izaiah-thigpen/tt-sparse-conv/pcb/placement/placement-preview.png

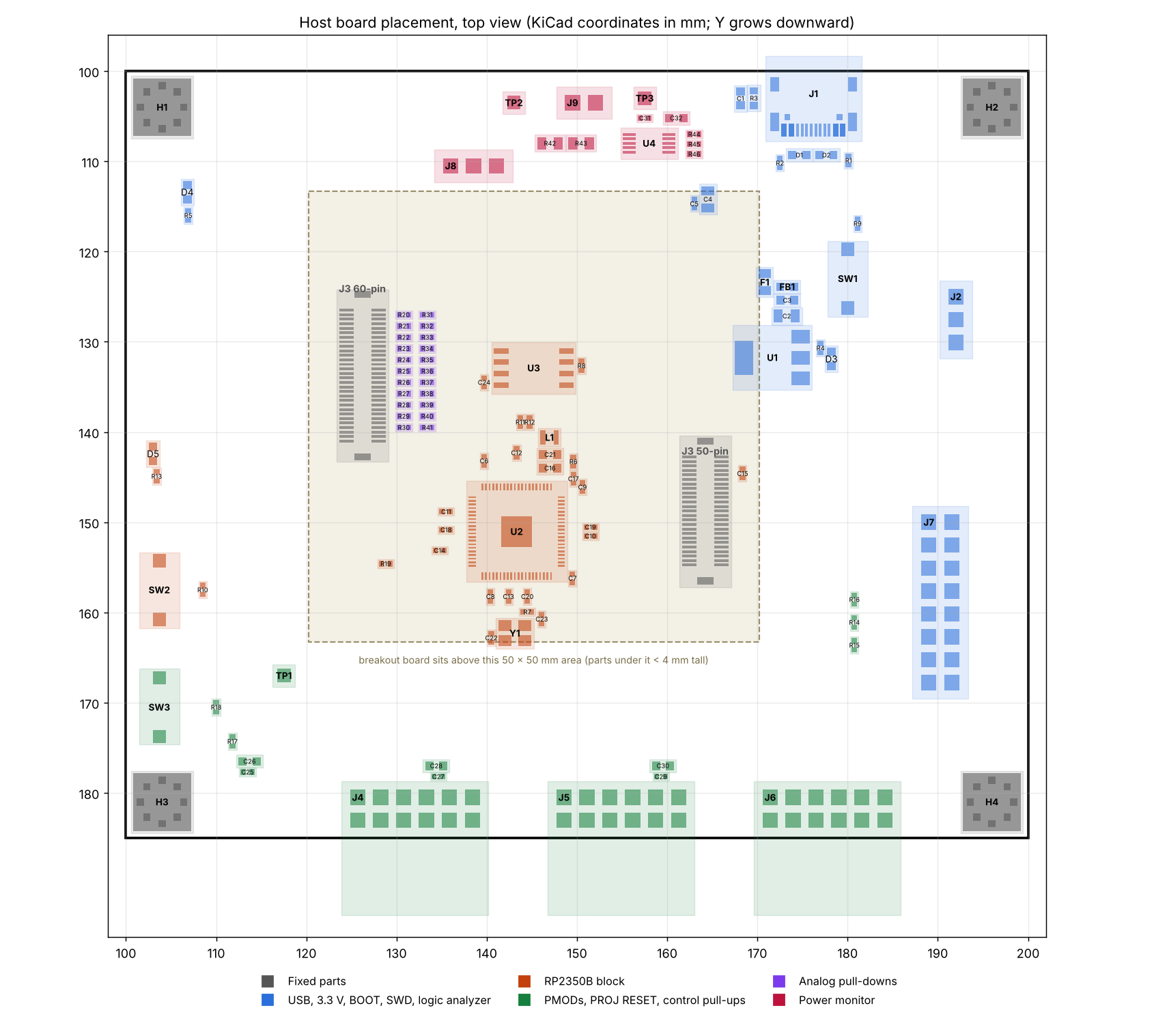
pcb/placement/placement-preview.png
