izaiah-thigpen/tt-sparse-conv/pcb/placement/placement.csv

group | ref | value | X (mm) | Y (mm) | Orientation (deg)
Fixed parts | H1 | M3 | 104.0 | 104.0 | 0
Fixed parts | H2 | M3 | 196.0 | 104.0 | 0
Fixed parts | H3 | M3 | 104.0 | 181.0 | 0
Fixed parts | H4 | M3 | 196.0 | 181.0 | 0
Fixed parts | J3 | TT breakout (DF12 60+50) | 126.225 | 133.8 | 0
USB, 3.3 V, BOOT, SWD, logic analyzer | C1 | 6800p | 168.11 | 103.025 | 90
USB, 3.3 V, BOOT, SWD, logic analyzer | C2 | 10u | 173.25 | 127.15 | 180
USB, 3.3 V, BOOT, SWD, logic analyzer | C3 | 1u | 173.3 | 125.4 | 180
USB, 3.3 V, BOOT, SWD, logic analyzer | C4 | 22u | 164.5 | 114.2 | 90
USB, 3.3 V, BOOT, SWD, logic analyzer | C5 | 100n | 163.0 | 114.7 | 90
USB, 3.3 V, BOOT, SWD, logic analyzer | D1 | ESD | 174.645 | 109.3 | 0
USB, 3.3 V, BOOT, SWD, logic analyzer | D2 | ESD | 177.645 | 109.3 | 180
USB, 3.3 V, BOOT, SWD, logic analyzer | D3 | Yellow | 178.2 | 131.9 | 90
USB, 3.3 V, BOOT, SWD, logic analyzer | D4 | Yellow | 106.8 | 113.41 | -90
USB, 3.3 V, BOOT, SWD, logic analyzer | F1 | 350mA | 170.8 | 123.4 | -90
USB, 3.3 V, BOOT, SWD, logic analyzer | FB1 | 120R | 173.3 | 123.9 | 0
USB, 3.3 V, BOOT, SWD, logic analyzer | J1 | USB_C | 176.21 | 102.5 | 180
USB, 3.3 V, BOOT, SWD, logic analyzer | J2 | SWD | 192.0 | 125.0 | 0
USB, 3.3 V, BOOT, SWD, logic analyzer | J7 | Logic analyzer | 189.0 | 150.0 | 0
USB, 3.3 V, BOOT, SWD, logic analyzer | R1 | 5.1k | 180.1 | 109.91 | -90
USB, 3.3 V, BOOT, SWD, logic analyzer | R2 | 5.1k | 172.5 | 110.19 | -90
USB, 3.3 V, BOOT, SWD, logic analyzer | R3 | 1M | 169.61 | 103.0 | 90
USB, 3.3 V, BOOT, SWD, logic analyzer | R4 | 1.2k | 177.0 | 130.7 | -90
USB, 3.3 V, BOOT, SWD, logic analyzer | R5 | 510 | 106.9 | 116.0 | 90
USB, 3.3 V, BOOT, SWD, logic analyzer | R9 | 1k | 181.1 | 116.9 | 90
USB, 3.3 V, BOOT, SWD, logic analyzer | SW1 | BOOT | 180.0 | 123.0 | 90
USB, 3.3 V, BOOT, SWD, logic analyzer | U1 | TLV1117LV33 | 171.65 | 131.75 | 180
RP2350B block | C6 | 100n | 139.7 | 143.2 | 90
RP2350B block | C7 | 100n | 149.5 | 156.2 | -90
RP2350B block | C8 | 100n | 140.4 | 158.235 | -90
RP2350B block | C9 | 100n | 150.6 | 146.1 | 90
RP2350B block | C10 | 100n | 151.488 | 151.535 | 0
RP2350B block | C11 | 100n | 135.488 | 148.835 | 180
RP2350B block | C12 | 100n | 143.3 | 142.3 | 90
RP2350B block | C13 | 100n | 142.4 | 158.235 | -90
RP2350B block | C14 | 100n | 134.771 | 153.127 | 180
RP2350B block | C15 | 100n | 168.35 | 144.6 | 90
RP2350B block | C16 | 4.7u | 147.0 | 144.0 | 0
RP2350B block | C17 | 4.7u | 149.6 | 145.18 | -90
RP2350B block | C18 | 100n | 135.488 | 150.835 | 180
RP2350B block | C19 | 100n | 151.488 | 150.535 | 0
RP2350B block | C20 | 4.7u | 144.488 | 158.235 | -90
RP2350B block | C21 | 4.7u | 147.0 | 142.5 | 0
RP2350B block | C22 | 14p | 140.5 | 162.82 | 90
RP2350B block | C23 | 14p | 146.088 | 160.735 | -90
RP2350B block | C24 | 100n | 139.7 | 134.5 | 90
RP2350B block | D5 | Yellow | 103.0 | 142.41 | -90
RP2350B block | L1 | 3.3u | 146.95 | 140.6 | 0
RP2350B block | R6 | 33 | 149.6 | 143.28 | -90
RP2350B block | R7 | 1k | 144.488 | 159.935 | 0
RP2350B block | R8 | 10k | 150.5 | 132.665 | -90
RP2350B block | R10 | 10k | 108.5 | 157.5 | 90
RP2350B block | R11 | 27 | 143.7 | 138.9 | -90
RP2350B block | R12 | 27 | 144.75 | 138.9 | -90
RP2350B block | R13 | 510 | 103.4 | 144.91 | 90
RP2350B block | R19 | 33 | 128.8 | 154.6 | 180
RP2350B block | SW2 | RESET | 103.7 | 157.5 | 90
RP2350B block | U2 | RP2350B | 143.317 | 151.035 | 0
RP2350B block | U3 | W25Q32JVSS | 145.2 | 132.9 | 180
RP2350B block | Y1 | 12MHz | 143.1 | 162.3 | 0
PMODs, PROJ RESET, control pull-ups | C25 | 100n | 113.475 | 177.69 | 0
PMODs, PROJ RESET, control pull-ups | C26 | 1u | 113.7 | 176.5 | 180
PMODs, PROJ RESET, control pull-ups | C27 | 100n | 134.62 | 178.2 | 180
PMODs, PROJ RESET, control pull-ups | C28 | 1u | 134.395 | 177.0 | 0
PMODs, PROJ RESET, control pull-ups | C29 | 100n | 159.3 | 178.2 | 0
PMODs, PROJ RESET, control pull-ups | C30 | 1u | 159.525 | 176.99 | 180
PMODs, PROJ RESET, control pull-ups | J4 | PMOD in (ui_in) | 125.7 | 180.5 | 90
PMODs, PROJ RESET, control pull-ups | J5 | PMOD bidir (uio) | 148.56 | 180.5 | 90
PMODs, PROJ RESET, control pull-ups | J6 | PMOD out (uo_out) | 171.42 | 180.5 | 90
PMODs, PROJ RESET, control pull-ups | R14 | 10k | 180.75 | 161.1 | -90
PMODs, PROJ RESET, control pull-ups | R15 | 5.1k | 180.75 | 163.63 | -90
PMODs, PROJ RESET, control pull-ups | R16 | 10k | 180.75 | 158.57 | 90
PMODs, PROJ RESET, control pull-ups | R17 | 1k | 111.8 | 174.3 | 90
PMODs, PROJ RESET, control pull-ups | R18 | 10k | 110.0 | 170.5 | 90
PMODs, PROJ RESET, control pull-ups | SW3 | PROJ RESET | 103.7 | 170.5 | -90
PMODs, PROJ RESET, control pull-ups | TP1 | PROJ_CLK | 117.5 | 167.0 | 0
Analog pull-downs | R20 | 10M | 130.8 | 127.0 | 0
Analog pull-downs | R21 | 10M | 130.8 | 128.25 | 0
Analog pull-downs | R22 | 10M | 130.8 | 129.5 | 0
Analog pull-downs | R23 | 10M | 130.8 | 130.75 | 0
Analog pull-downs | R24 | 10M | 130.8 | 132.0 | 0
Analog pull-downs | R25 | 10M | 130.8 | 133.25 | 0
Analog pull-downs | R26 | 10M | 130.8 | 134.5 | 0
Analog pull-downs | R27 | 10M | 130.8 | 135.75 | 0
Analog pull-downs | R28 | 10M | 130.8 | 137.0 | 0
Analog pull-downs | R29 | 10M | 130.8 | 138.25 | 0
Analog pull-downs | R30 | 10M | 130.8 | 139.5 | 0
Analog pull-downs | R31 | 10M | 133.4 | 127.0 | 0
Analog pull-downs | R32 | 10M | 133.4 | 128.25 | 0
Analog pull-downs | R33 | 10M | 133.4 | 129.5 | 0
Analog pull-downs | R34 | 10M | 133.4 | 130.75 | 0
Analog pull-downs | R35 | 10M | 133.4 | 132.0 | 0
Analog pull-downs | R36 | 10M | 133.4 | 133.25 | 0
Analog pull-downs | R37 | 10M | 133.4 | 134.5 | 0
Analog pull-downs | R38 | 10M | 133.4 | 135.75 | 0
Analog pull-downs | R39 | 10M | 133.4 | 137.0 | 0
Analog pull-downs | R40 | 10M | 133.4 | 138.25 | 0
Analog pull-downs | R41 | 10M | 133.4 | 139.5 | 0
Power monitor | C31 | 100n | 157.5 | 105.2 | 0
Power monitor | C32 | 1u | 161.0 | 105.2 | 0
Power monitor | J8 | CORE | 136.0 | 110.5 | 90
Power monitor | J9 | RANGE | 149.5 | 103.5 | 90
Power monitor | R42 | 0.499 | 147.0 | 108.0 | 0
Power monitor | R43 | 4.99 | 150.45 | 108.0 | 0
Power monitor | R44 | 4.7k | 163.0 | 107.0 | 0
Power monitor | R45 | 4.7k | 163.0 | 108.1 | 0
Power monitor | R46 | 10k | 163.0 | 109.2 | 0
Power monitor | TP2 | VCORE_IN | 143.0 | 103.5 | 0
Power monitor | TP3 | VCORE_OUT | 157.5 | 103.0 | 0
Power monitor | U4 | INA228 | 158.0 | 108.0 | 180
