izaiah-thigpen/tt-sparse-conv/power/results/power.md

| Zero share | Chip gated (µW) | Chip BYPASS (µW) | Chip saving | Saving above idle | MAC gated (µW) | MAC BYPASS (µW) | MAC saving | MAC dynamic saving |
| --- | --- | --- | --- | --- | --- | --- | --- | --- |
| 0% | 1070.8 | 1070.8 | 0.0% | 0.0% | 353.4 | 353.4 | 0.0% | 0.0% |
| 25% | 1029.6 | 1051.5 | 2.1% | 6.4% | 311.6 | 333.4 | 6.5% | 10.2% |
| 50% | 973.2 | 1015.4 | 4.2% | 13.8% | 258.1 | 300.3 | 14.0% | 23.3% |
| 75% | 910.9 | 971.1 | 6.2% | 23.0% | 200.1 | 260.3 | 23.1% | 42.8% |
| 90% | 864.5 | 936.2 | 7.7% | 31.6% | 156.1 | 227.9 | 31.5% | 66.3% |

Idle (clock running, no computation): chip 709.1 µW, MAC 119.6 µW
