izaiah-thigpen/tt-sparse-conv/power/results/power.csv

condition | zero_share | total_uW | sequential_uW | combinational_uW | leakage_uW | mac_uW
idle |  | 709.12 | 709.12 | 0.00 | 0.0083 | 119.61
T0_gated | 0.0 | 1070.82 | 810.05 | 260.78 | 0.0082 | 353.42
T0_bypass | 0.0 | 1070.82 | 810.05 | 260.78 | 0.0082 | 353.42
T64_gated | 0.25 | 1029.65 | 800.90 | 228.74 | 0.0082 | 311.57
T64_bypass | 0.25 | 1051.46 | 808.23 | 243.23 | 0.0082 | 333.38
T128_gated | 0.5 | 973.21 | 789.59 | 183.63 | 0.0082 | 258.14
T128_bypass | 0.5 | 1015.37 | 801.94 | 213.43 | 0.0082 | 300.29
T192_gated | 0.75 | 910.90 | 777.93 | 132.97 | 0.0083 | 200.13
T192_bypass | 0.75 | 971.12 | 792.58 | 178.54 | 0.0082 | 260.35
T230_gated | 0.8984375 | 864.45 | 769.11 | 95.34 | 0.0083 | 156.14
T230_bypass | 0.8984375 | 936.24 | 784.53 | 151.70 | 0.0081 | 227.92
