izaiah-thigpen/tt-sparse-conv/pcb/sparse-conv-host-schematic.pdf

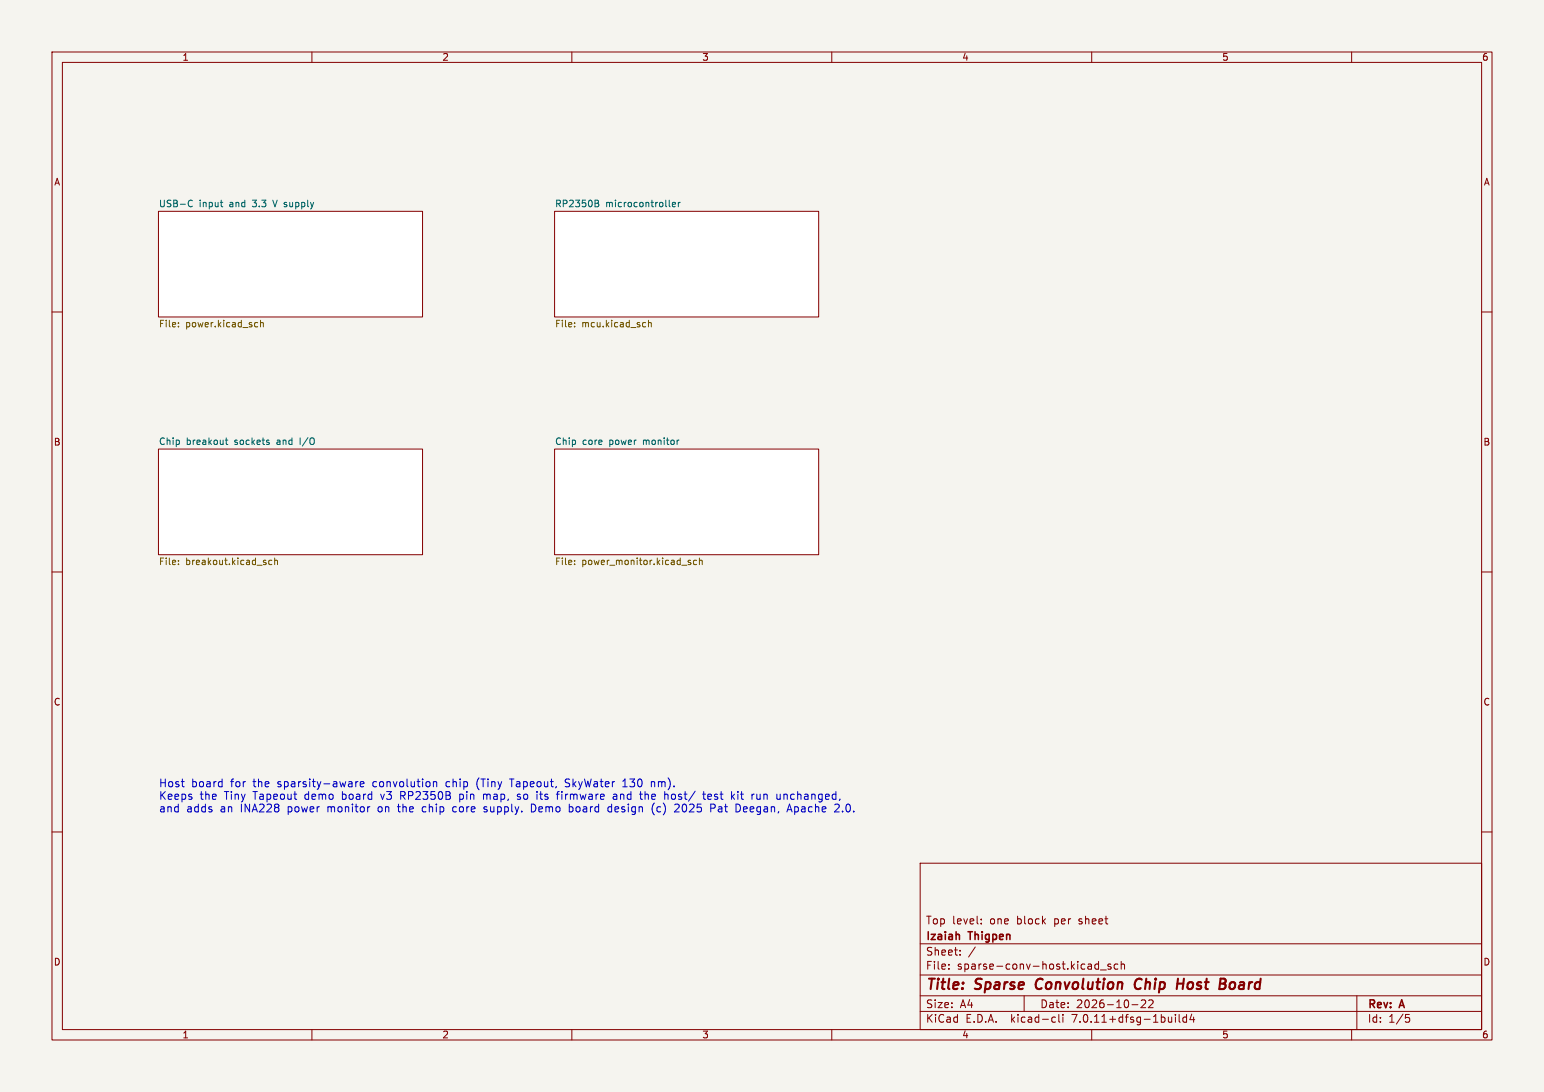
[picture p6: page 1]

File: sparse-conv-host.kicad_sch Sheet: /
Id: 1/5 Title: Sparse Convolution Chip Host Board

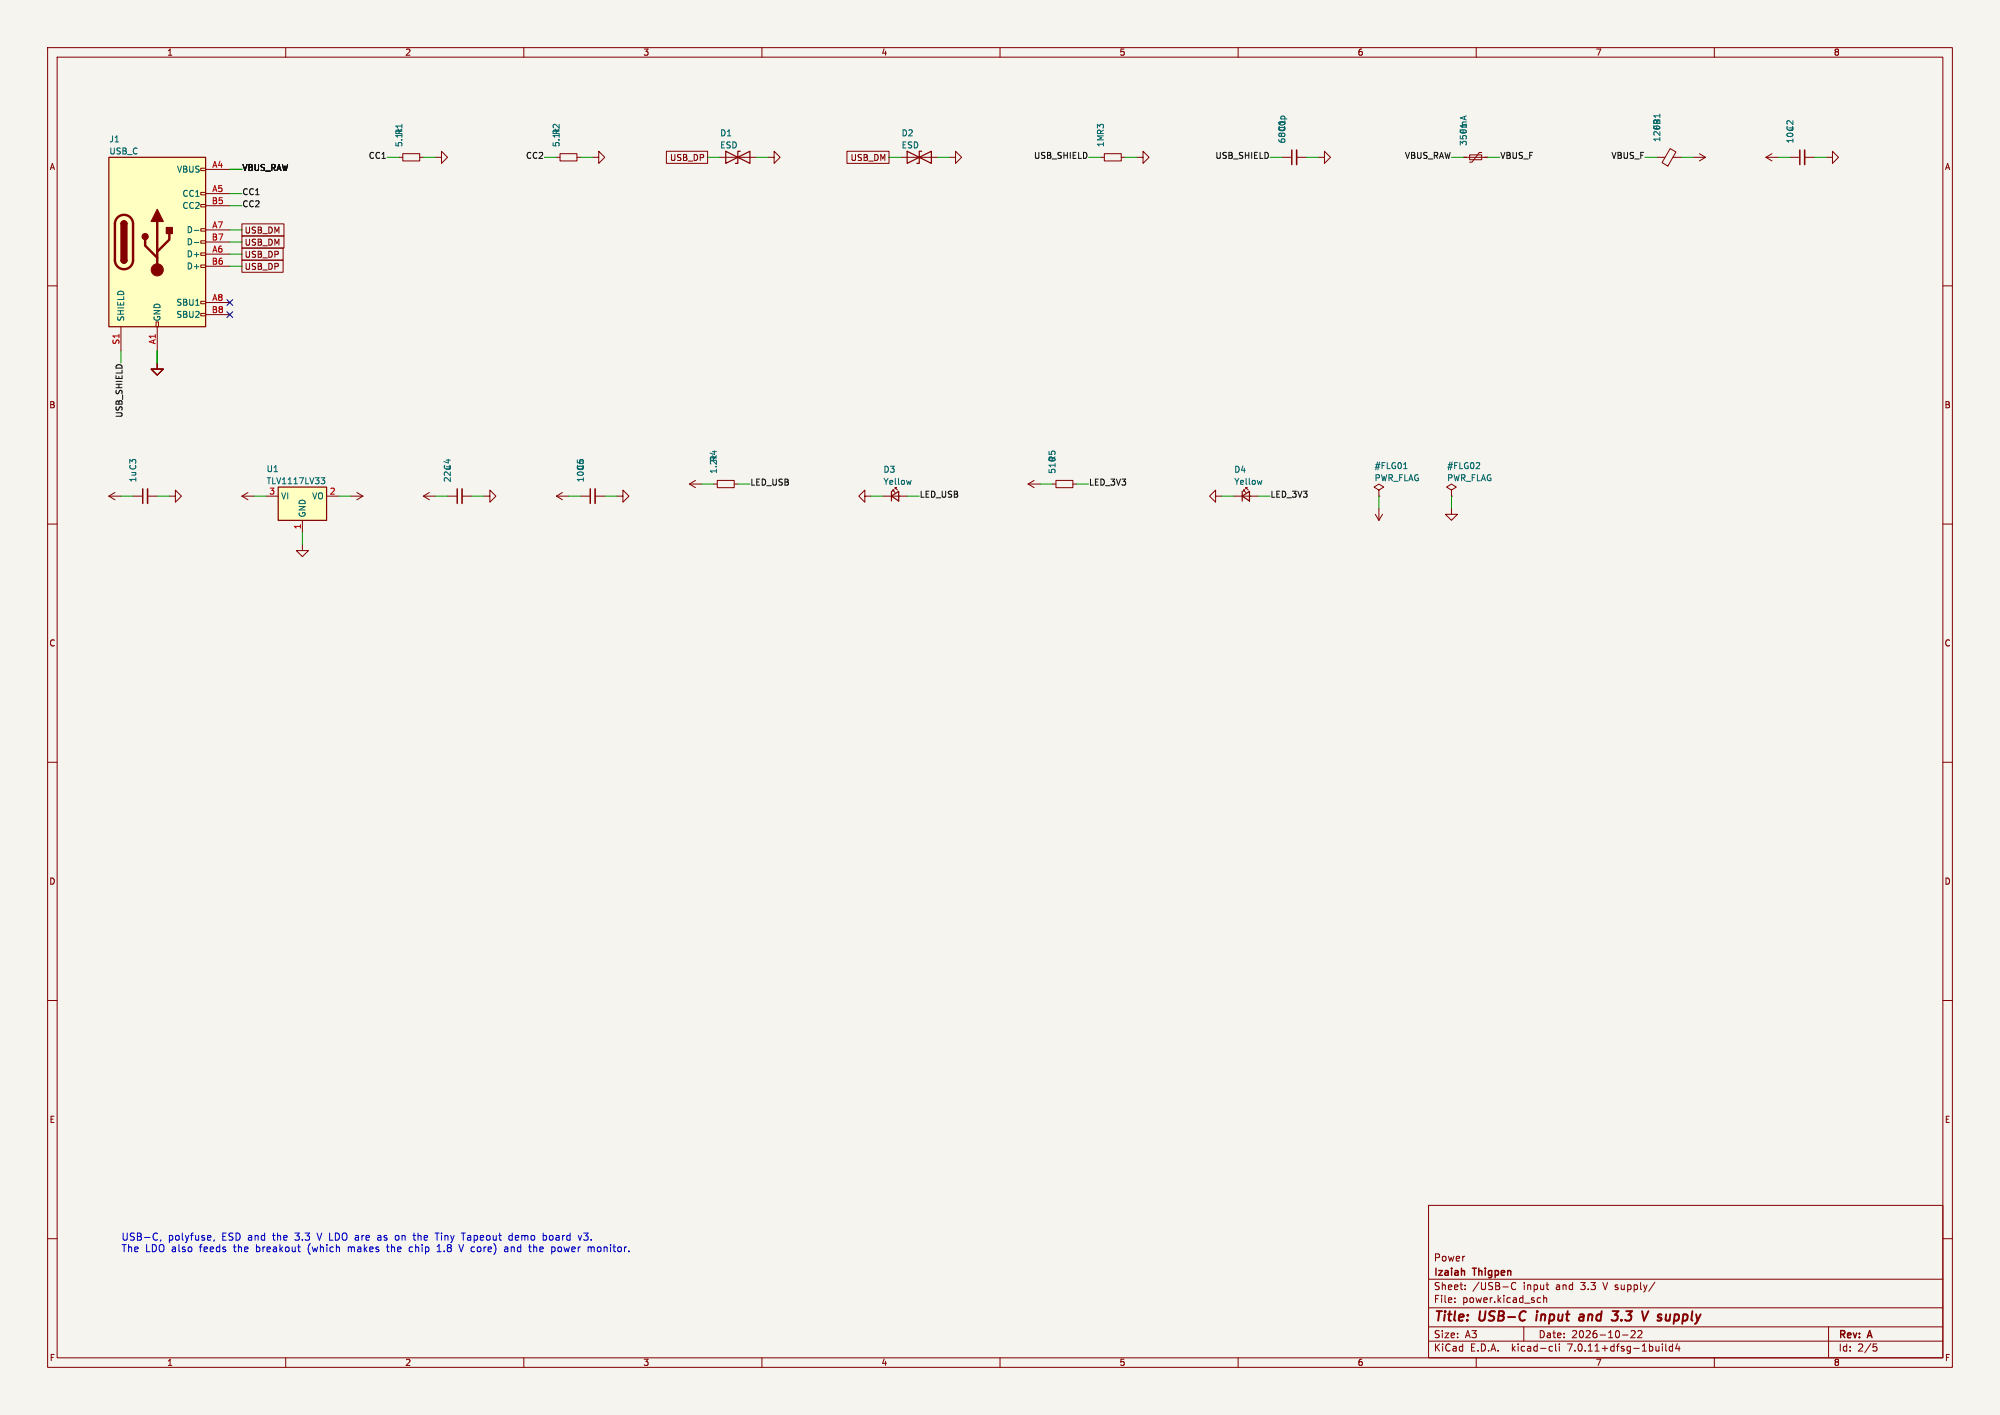
[picture p7: page 2]

Id: 2/5 Title: USB-C input and 3.3 V supply

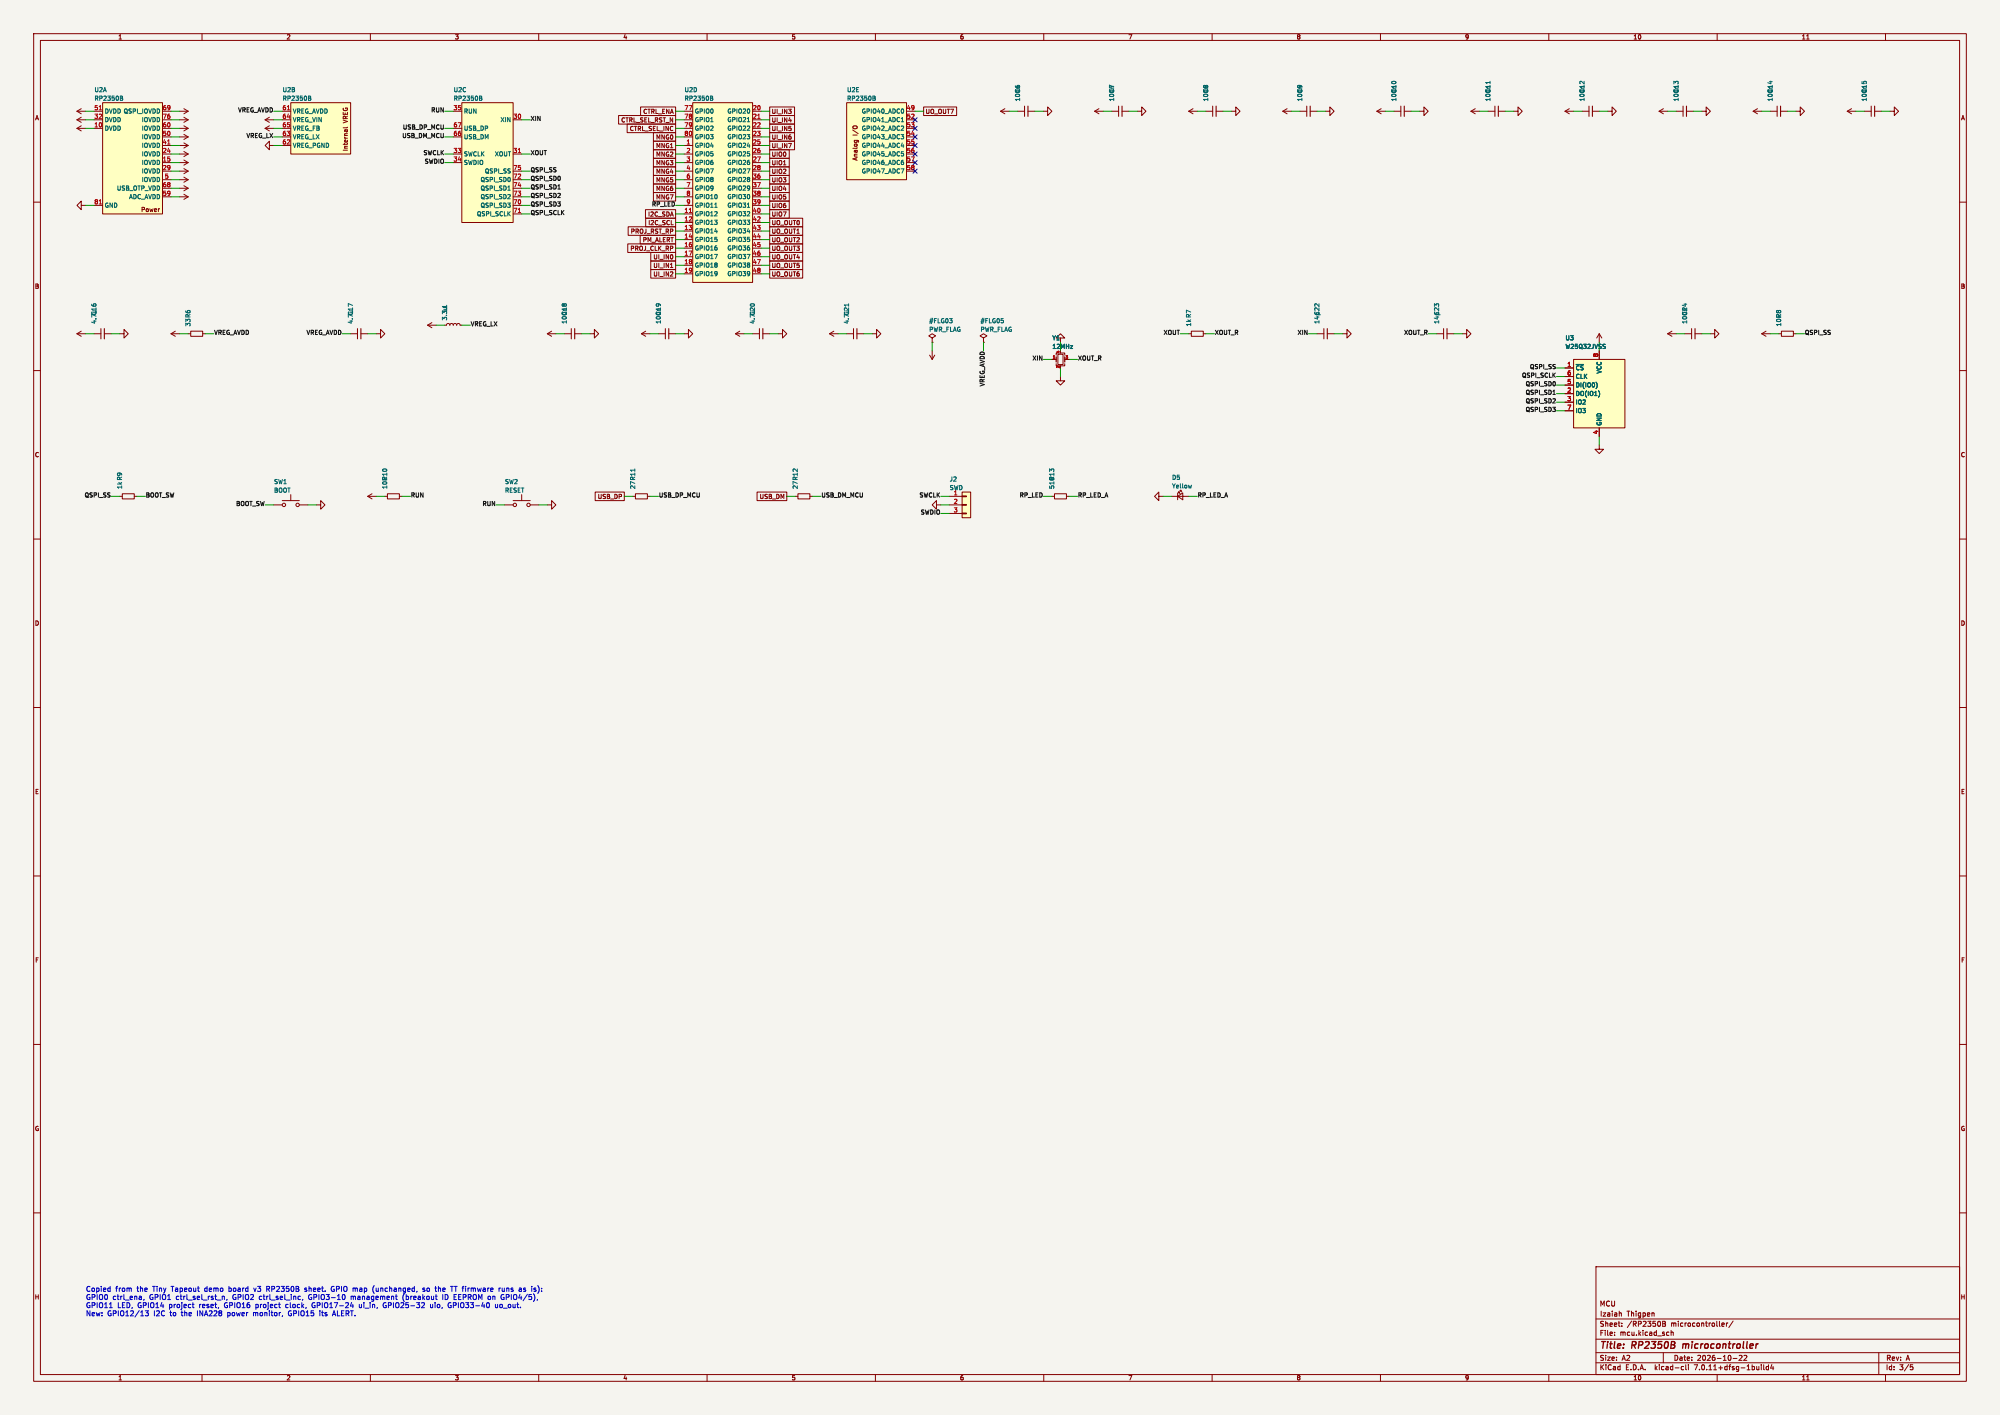
[picture p8: page 3]

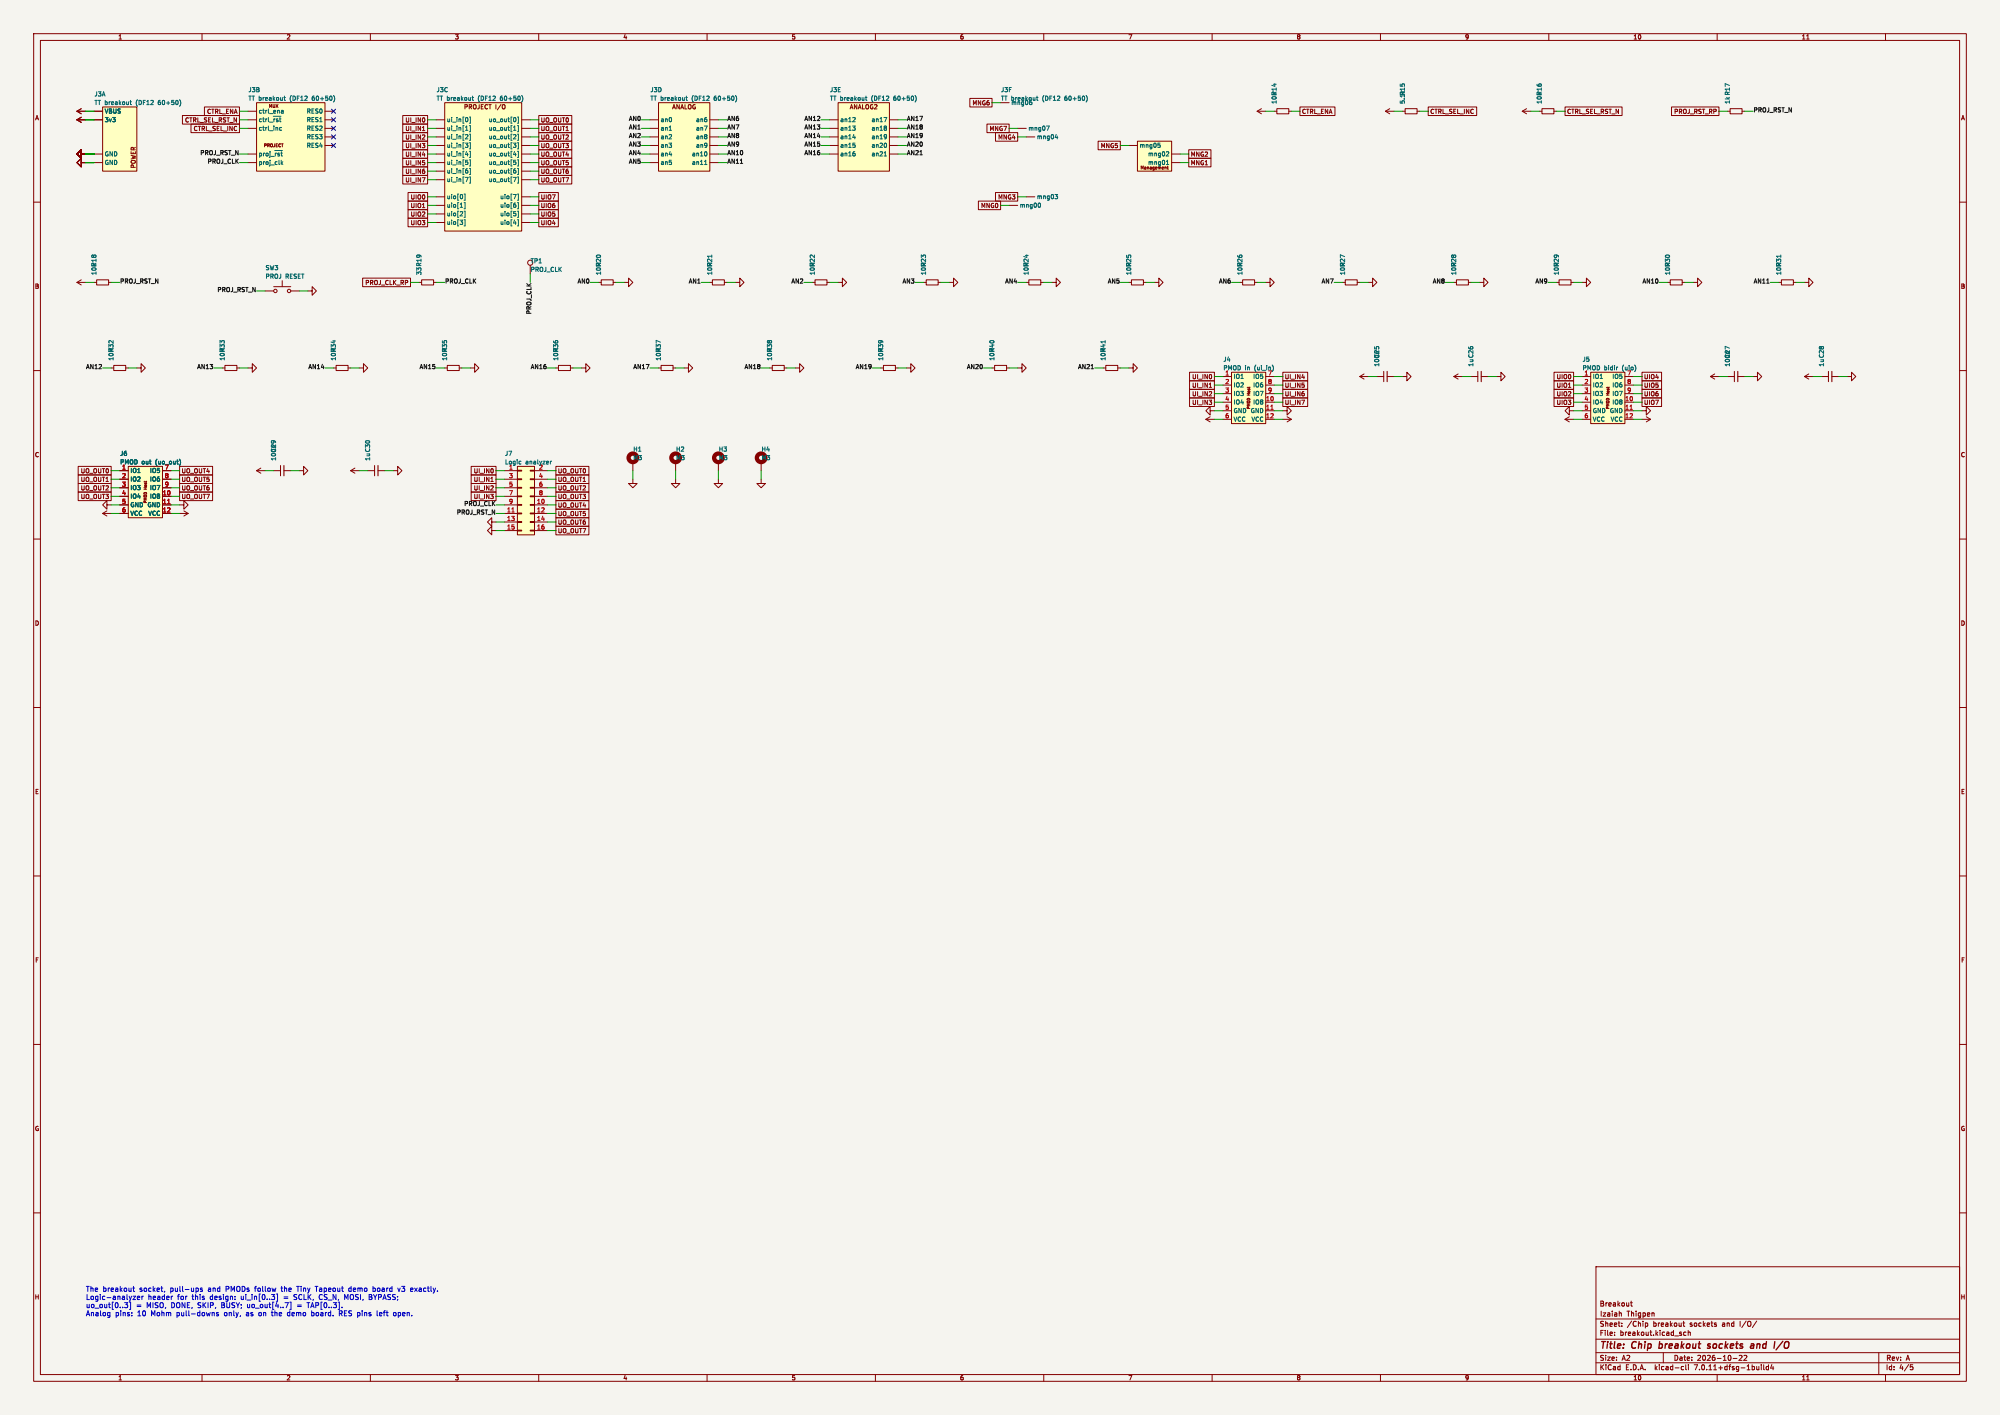
[picture p9: page 4]

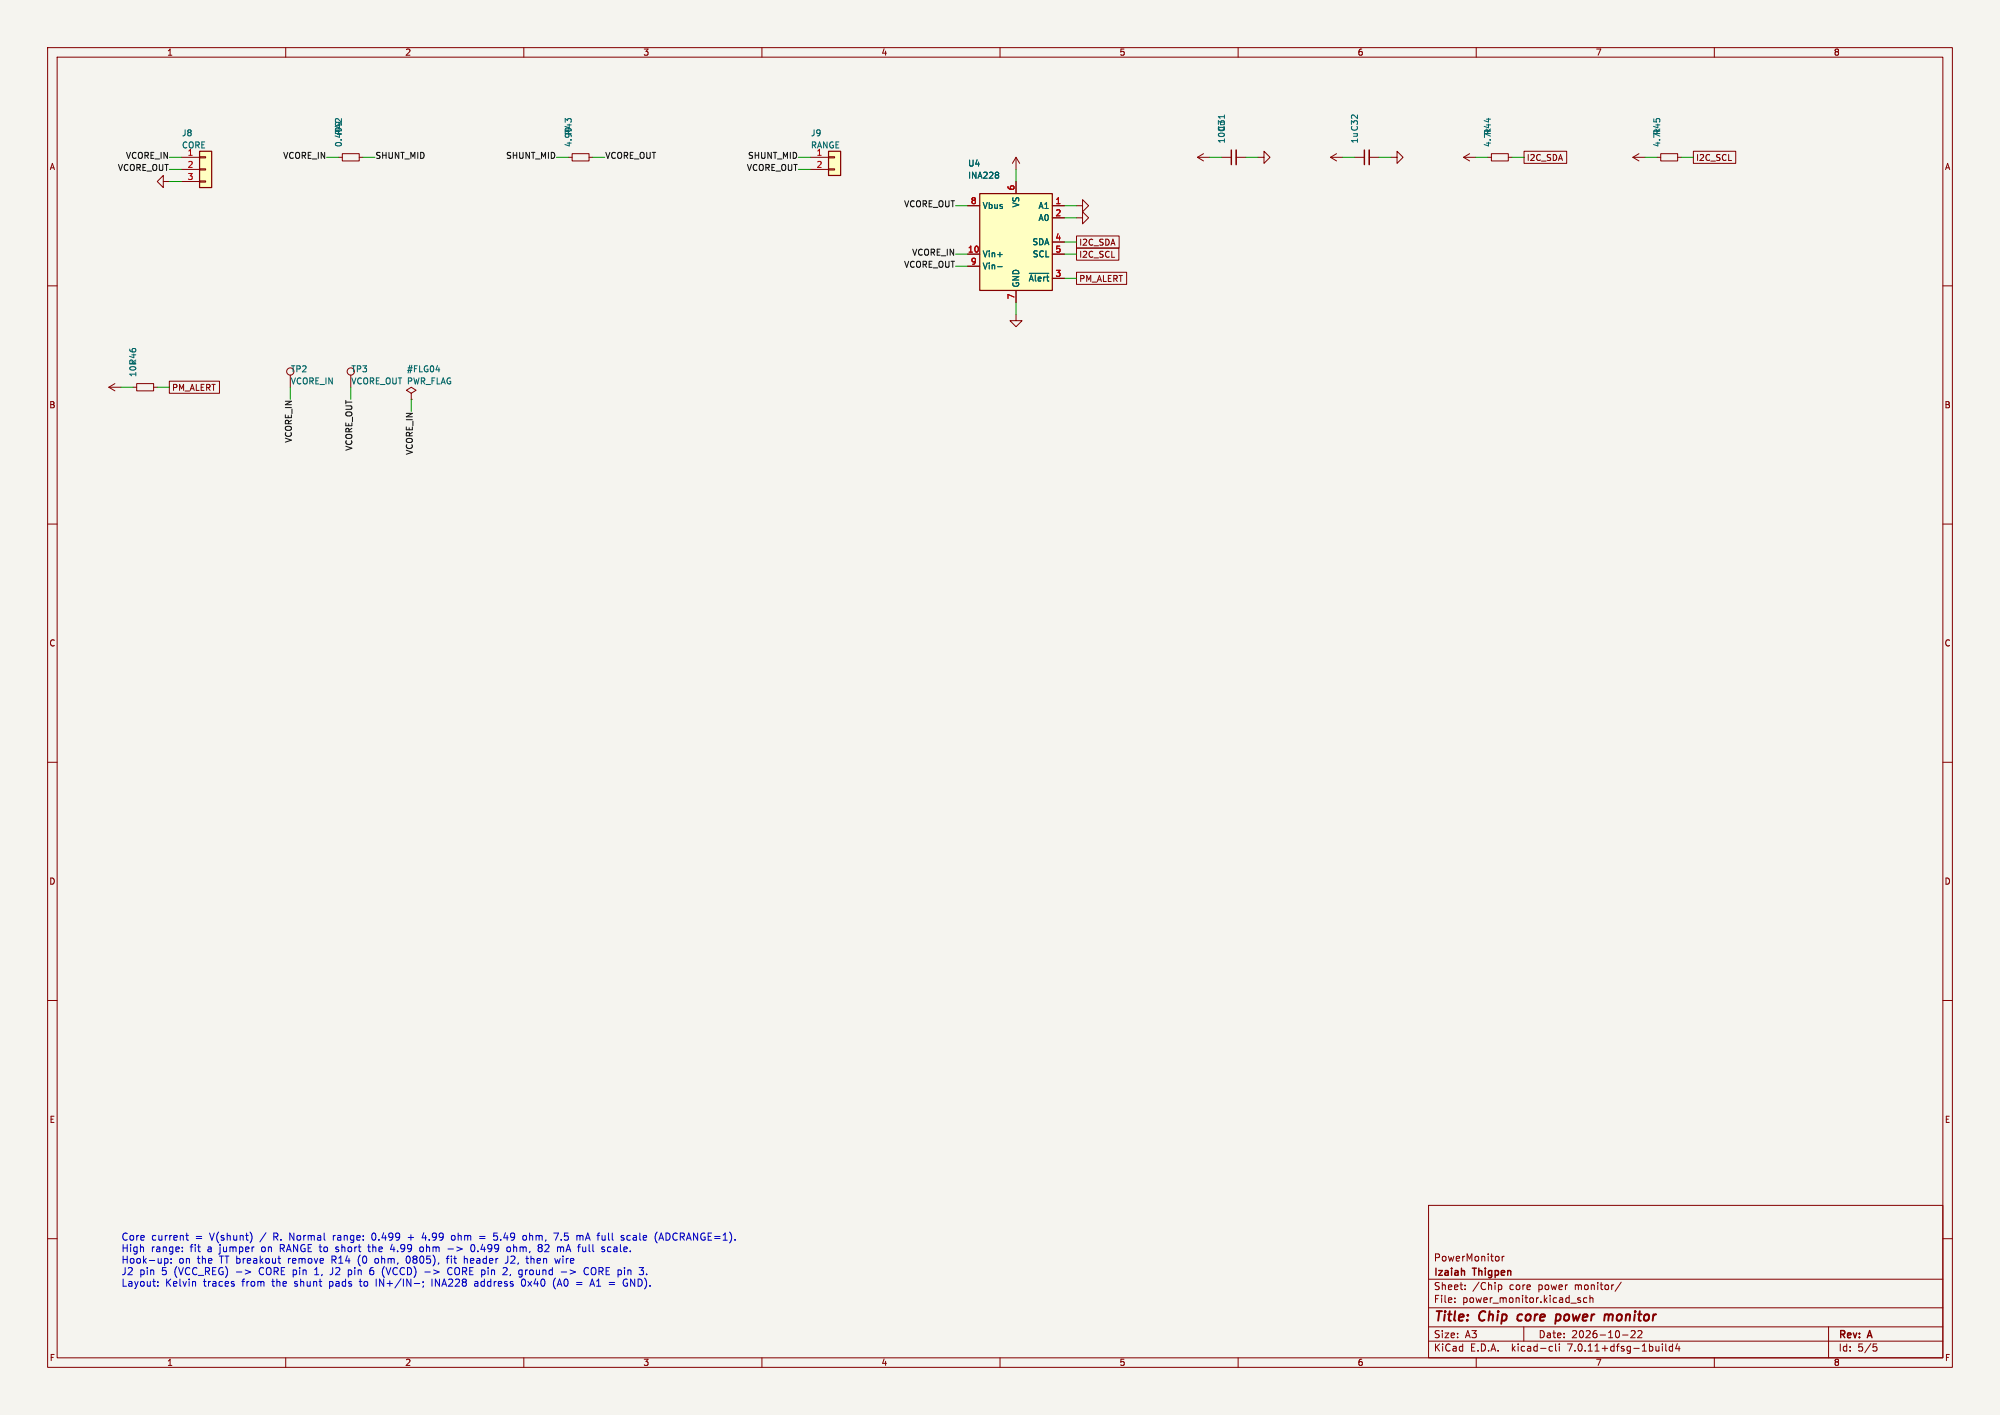
[picture p10: page 5]
