izaiah-thigpen/tt-sparse-conv/pcb/placement/sparse-conv-host-placed.kicad_pcb

## KiCad design pcb/placement/sparse-conv-host-placed.kicad_pcb (2026-10-24)

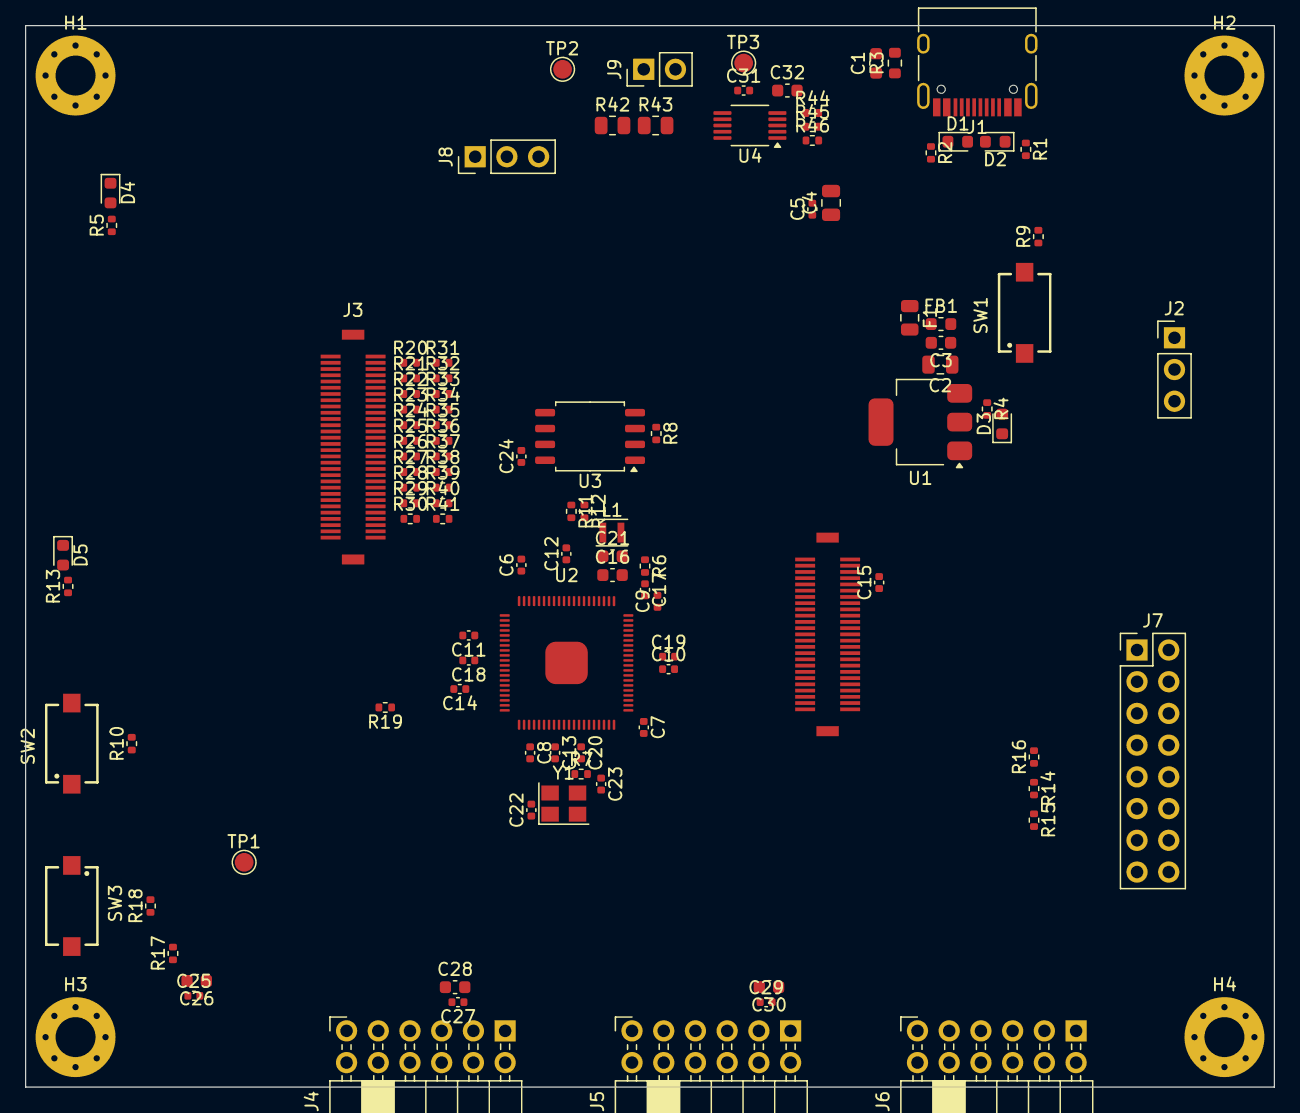
[picture p11: board sparse-conv-host-placed.kicad_pcb from above]

Board: 4 copper layers, 100.0 x 85.0 mm, 110 parts (0 on the bottom side), 99 nets, no tracks yet.

Parts:
C1, C3, C16, C21, C26, C28, C30, C32: C_0603_1608Metric
C2, C4: C_0805_2012Metric
C5, C6, C7, C8, C9, C10, C11, C12, C13, C14, C15, C17, C18, C19, C20, C22, C23, C24, C25, C27, C29, C31: C_0402_1005Metric
D1, D2: D_0603_1608Metric
D3, D4, D5: LED_0603_1608Metric
F1: Fuse_0805_2012Metric
FB1: L_0603_1608Metric
H1, H2, H3, H4: MountingHole_3.2mm_M3_Pad_Via
J1: USB_C_Receptacle_HRO_TYPE-C-31-M-12
J2, J8: PinHeader_1x03_P2.54mm_Vertical
J3: TT; TT_HRS_CARRIER_REVC
J4, J5, J6: PinSocket_2x06_P2.54mm_PMODHost1A
J7: PinHeader_2x08_P2.54mm_Vertical
J9: PinHeader_1x02_P2.54mm_Vertical
L1: L_Murata_DFE201610P
R1, R2, R4, R5, R6, R7, R8, R9, R10, R11, R12, R13, R14, R15, R16, R17, R18, R19, R20, R21, R22, R23, R24, R25, R26, R27, R28, R29, R30, R31, R32, R33, R34, R35, R36, R37, R38, R39, R40, R41, R44, R45, R46: R_0402_1005Metric
R3: R_0603_1608Metric
R42, R43: R_0805_2012Metric
SW1, SW2, SW3: 434121025816
TP1, TP2, TP3: TestPoint_Pad_D1.5mm
U1: SOT-223-3_TabPin2
U2: QFN; QFN-80-1EP_10x10mm_P0.4mm_EP3.4x3.4mm
U3: SOIC-8_5.275x5.275mm_P1.27mm
U4: VSSOP-10_3x3mm_P0.5mm
Y1: Crystal_SMD_3225-4Pin_3.2x2.5mm

Connections:
+1V1: C18.1, C19.1, C20.1, C21.1, L1.1, U2.10, U2.32, U2.51, U2.65
+3V3: C4.1, C5.1, C6.1, C7.1, C8.1, C9.1, C10.1, C11.1, C12.1, C13.1, C14.1, C15.1, C16.1, C24.1, C25.1, C26.1, C27.1, C28.1, C29.1, C30.1, C31.1, C32.1, J3.L1, J3.R8, J3.R10, J4.6, J4.12, J5.6, J5.12, J6.6, J6.12, R5.1, R6.1, R8.1, R10.1, R14.1, R15.1, R16.1, R18.1, R44.1, R45.1, R46.1, U1.2, U2.5, U2.15, U2.24, U2.29, U2.41, U2.50, U2.59, U2.60, U2.64, U2.68, U2.69, U2.76, U3.8, U4.6
+5V: C2.1, C3.1, FB1.2, J3.R2, J3.R4, R4.1, U1.3
/Chip breakout sockets and I/O/AN0: J3.L2, R20.1
/Chip breakout sockets and I/O/AN1: J3.L4, R21.1
/Chip breakout sockets and I/O/AN2: J3.L6, R22.1
/Chip breakout sockets and I/O/AN3: J3.L10, R23.1
/Chip breakout sockets and I/O/AN4: J3.L12, R24.1
/Chip breakout sockets and I/O/AN5: J3.L14, R25.1
/Chip breakout sockets and I/O/AN6: J3.L18, R26.1
/Chip breakout sockets and I/O/AN7: J3.L20, R27.1
/Chip breakout sockets and I/O/AN8: J3.L22, R28.1
/Chip breakout sockets and I/O/AN9: J3.L26, R29.1
/Chip breakout sockets and I/O/AN10: J3.L28, R30.1
/Chip breakout sockets and I/O/AN11: J3.L30, R31.1
/Chip breakout sockets and I/O/AN12: J3.L34, R32.1
/Chip breakout sockets and I/O/AN13: J3.L36, R33.1
/Chip breakout sockets and I/O/AN14: J3.L38, R34.1
/Chip breakout sockets and I/O/AN15: J3.L42, R35.1
/Chip breakout sockets and I/O/AN16: J3.L44, R36.1
/Chip breakout sockets and I/O/AN17: J3.L46, R37.1
/Chip breakout sockets and I/O/AN18: J3.L50, R38.1
/Chip breakout sockets and I/O/AN19: J3.L52, R39.1
/Chip breakout sockets and I/O/AN20: J3.L54, R40.1
/Chip breakout sockets and I/O/AN21: J3.L58, R41.1
/Chip breakout sockets and I/O/PROJ_CLK: J3.L57, J7.9, R19.2, TP1.1
/Chip breakout sockets and I/O/PROJ_RST_N: J3.L53, J7.11, R17.2, R18.2, SW3.1
/Chip core power monitor/SHUNT_MID: J9.1, R42.2, R43.1
/Chip core power monitor/VCORE_IN: J8.1, R42.1, TP2.1, U4.10
/Chip core power monitor/VCORE_OUT: J8.2, J9.2, R43.2, TP3.1, U4.8, U4.9
/RP2350B microcontroller/BOOT_SW: R9.2, SW1.1
/RP2350B microcontroller/QSPI_SCLK: U2.71, U3.6
/RP2350B microcontroller/QSPI_SD0: U2.72, U3.5
/RP2350B microcontroller/QSPI_SD1: U2.74, U3.2
/RP2350B microcontroller/QSPI_SD2: U2.73, U3.3
/RP2350B microcontroller/QSPI_SD3: U2.70, U3.7
/RP2350B microcontroller/QSPI_SS: R8.2, R9.1, U2.75, U3.1
/RP2350B microcontroller/RP_LED: R13.1, U2.9
/RP2350B microcontroller/RP_LED_A: D5.2, R13.2
/RP2350B microcontroller/RUN: R10.2, SW2.1, U2.35
/RP2350B microcontroller/SWCLK: J2.1, U2.33
/RP2350B microcontroller/SWDIO: J2.3, U2.34
/RP2350B microcontroller/USB_DM_MCU: R12.2, U2.66
/RP2350B microcontroller/USB_DP_MCU: R11.2, U2.67
/RP2350B microcontroller/VREG_AVDD: C17.1, R6.2, U2.61
/RP2350B microcontroller/VREG_LX: L1.2, U2.63
/RP2350B microcontroller/XIN: C22.1, U2.30, Y1.1
/RP2350B microcontroller/XOUT: R7.1, U2.31
/RP2350B microcontroller/XOUT_R: C23.1, R7.2, Y1.3
/USB-C input and 3.3 V supply/CC1: J1.A5, R1.1
/USB-C input and 3.3 V supply/CC2: J1.B5, R2.1
/USB-C input and 3.3 V supply/LED_3V3: D4.2, R5.2
/USB-C input and 3.3 V supply/LED_USB: D3.2, R4.2
/USB-C input and 3.3 V supply/USB_SHIELD: C1.1, J1.S1, R3.1
/USB-C input and 3.3 V supply/VBUS_F: F1.2, FB1.1
/USB-C input and 3.3 V supply/VBUS_RAW: F1.1, J1.A4, J1.A9, J1.B4, J1.B9
CTRL_ENA: J3.R46, R14.2, U2.77
CTRL_SEL_INC: J3.R47, R15.2, U2.79
CTRL_SEL_RST_N: J3.R43, R16.2, U2.78
GND: C1.2, C2.2, C3.2, C4.2, C5.2, C6.2, C7.2, C8.2, C9.2, C10.2, C11.2, C12.2, C13.2, C14.2, C15.2, C16.2, C17.2, C18.2, C19.2, C20.2, C21.2, C22.2, C23.2, C24.2, C25.2, C26.2, C27.2, C28.2, C29.2, C30.2, C31.2, C32.2, D1.2, D2.2, D3.1, D4.1, D5.1, H1.1, H2.1, H3.1, H4.1, J1.A1, J1.A12, J1.B1, J1.B12, J2.2, J3.L3, J3.L8, J3.L11, J3.L16, J3.L19, J3.L24, J3.L27, J3.L32, J3.L35, J3.L40, J3.L43, J3.L48, J3.L51, J3.L55, J3.L56, J3.L59, J3.R1, J3.R6, J3.R11, J3.R12, J3.R20, J3.R21, J3.R28, J3.R33, J3.R38, J3.R41, J3.R44, J3.R45, J3.R48, J4.5, J4.11, J5.5, J5.11, J6.5, J6.11, J7.13, J7.15, J8.3, R1.2, R2.2, R3.2, R20.2, R21.2, R22.2, R23.2, R24.2, R25.2, R26.2, R27.2, R28.2, R29.2, R30.2, R31.2, R32.2, R33.2, R34.2, R35.2, R36.2, R37.2, R38.2, R39.2, R40.2, R41.2, SW1.2, SW2.2, SW3.2, U1.1, U2.62, U2.81, U3.4, U4.1, U4.2, U4.7, Y1.2, Y1.4
I2C_SCL: R45.2, U2.12, U4.5
I2C_SDA: R44.2, U2.11, U4.4
MNG0: J3.R42, U2.80
MNG1: J3.R40, U2.1
MNG2: J3.R36, U2.2
MNG3: J3.R30, U2.3
MNG4: J3.R26, U2.4
MNG5: J3.R22, U2.6
MNG6: J3.R18, U2.7
MNG7: J3.R16, U2.8
PM_ALERT: R46.2, U2.14, U4.3
PROJ_CLK_RP: R19.1, U2.16
PROJ_RST_RP: R17.1, U2.13
UIO0: J3.L5, J5.1, U2.26
UIO1: J3.L7, J5.2, U2.27
UIO2: J3.L9, J5.3, U2.28
UIO3: J3.L13, J5.4, U2.36
UIO4: J3.L15, J5.7, U2.37
UIO5: J3.L17, J5.8, U2.38
UIO6: J3.L21, J5.9, U2.39
UIO7: J3.L23, J5.10, U2.40
UI_IN0: J3.L31, J4.1, J7.1, U2.17
UI_IN1: J3.L33, J4.2, J7.3, U2.18
UI_IN2: J3.L37, J4.3, J7.5, U2.19
UI_IN3: J3.L39, J4.4, J7.7, U2.20
UI_IN4: J3.L41, J4.7, U2.21
UI_IN5: J3.L45, J4.8, U2.22
UI_IN6: J3.L47, J4.9, U2.23
UI_IN7: J3.L49, J4.10, U2.25
UO_OUT0: J3.R19, J6.1, J7.2, U2.42
UO_OUT1: J3.R17, J6.2, J7.4, U2.43
UO_OUT2: J3.R15, J6.3, J7.6, U2.44
UO_OUT3: J3.R13, J6.4, J7.8, U2.45
UO_OUT4: J3.R9, J6.7, J7.10, U2.46
UO_OUT5: J3.R7, J6.8, J7.12, U2.47
UO_OUT6: J3.R5, J6.9, J7.14, U2.48
UO_OUT7: J3.R3, J6.10, J7.16, U2.49
USB_DM: D2.1, J1.A7, J1.B7, R12.1
USB_DP: D1.1, J1.A6, J1.B6, R11.1
