izaiah-thigpen/tt-sparse-conv/fpga/rtl/conv_engine_axi.v

// conv_engine_axi.v
//
// Top level for the PYNQ-Z1 block design. Plain Verilog so Vivado can use it
// as a module reference; the engine itself is SystemVerilog.
//
// Interfaces (Vivado infers them from the attributes below):
//   s_axil   AXI4-Lite control registers (see engine_regs.sv)
//   s_axis   AXI4-Stream pixels in, 8 bits, from the DMA's MM2S channel
//   m_axis   AXI4-Stream results out, 8 bits, to the DMA's S2MM channel
`default_nettype none

module conv_engine_axi (
    (* X_INTERFACE_INFO = "xilinx.com:signal:clock:1.0 aclk CLK" *)
    (* X_INTERFACE_PARAMETER = "ASSOCIATED_BUSIF s_axil:s_axis:m_axis, ASSOCIATED_RESET aresetn" *)
    input  wire        aclk,
    (* X_INTERFACE_INFO = "xilinx.com:signal:reset:1.0 aresetn RST" *)
    (* X_INTERFACE_PARAMETER = "POLARITY ACTIVE_LOW" *)
    input  wire        aresetn,

    (* X_INTERFACE_INFO = "xilinx.com:interface:aximm:1.0 s_axil AWADDR" *)
    input  wire [5:0]  s_axil_awaddr,
    (* X_INTERFACE_INFO = "xilinx.com:interface:aximm:1.0 s_axil AWVALID" *)
    input  wire        s_axil_awvalid,
    (* X_INTERFACE_INFO = "xilinx.com:interface:aximm:1.0 s_axil AWREADY" *)
    output wire        s_axil_awready,
    (* X_INTERFACE_INFO = "xilinx.com:interface:aximm:1.0 s_axil WDATA" *)
    input  wire [31:0] s_axil_wdata,
    (* X_INTERFACE_INFO = "xilinx.com:interface:aximm:1.0 s_axil WSTRB" *)
    input  wire [3:0]  s_axil_wstrb,
    (* X_INTERFACE_INFO = "xilinx.com:interface:aximm:1.0 s_axil WVALID" *)
    input  wire        s_axil_wvalid,
    (* X_INTERFACE_INFO = "xilinx.com:interface:aximm:1.0 s_axil WREADY" *)
    output wire        s_axil_wready,
    (* X_INTERFACE_INFO = "xilinx.com:interface:aximm:1.0 s_axil BRESP" *)
    output wire [1:0]  s_axil_bresp,
    (* X_INTERFACE_INFO = "xilinx.com:interface:aximm:1.0 s_axil BVALID" *)
    output wire        s_axil_bvalid,
    (* X_INTERFACE_INFO = "xilinx.com:interface:aximm:1.0 s_axil BREADY" *)
    input  wire        s_axil_bready,
    (* X_INTERFACE_INFO = "xilinx.com:interface:aximm:1.0 s_axil ARADDR" *)
    input  wire [5:0]  s_axil_araddr,
    (* X_INTERFACE_INFO = "xilinx.com:interface:aximm:1.0 s_axil ARVALID" *)
    input  wire        s_axil_arvalid,
    (* X_INTERFACE_INFO = "xilinx.com:interface:aximm:1.0 s_axil ARREADY" *)
    output wire        s_axil_arready,
    (* X_INTERFACE_INFO = "xilinx.com:interface:aximm:1.0 s_axil RDATA" *)
    output wire [31:0] s_axil_rdata,
    (* X_INTERFACE_INFO = "xilinx.com:interface:aximm:1.0 s_axil RRESP" *)
    output wire [1:0]  s_axil_rresp,
    (* X_INTERFACE_INFO = "xilinx.com:interface:aximm:1.0 s_axil RVALID" *)
    output wire        s_axil_rvalid,
    (* X_INTERFACE_INFO = "xilinx.com:interface:aximm:1.0 s_axil RREADY" *)
    (* X_INTERFACE_PARAMETER = "PROTOCOL AXI4LITE, DATA_WIDTH 32, ADDR_WIDTH 6" *)
    input  wire        s_axil_rready,

    (* X_INTERFACE_INFO = "xilinx.com:interface:axis:1.0 s_axis TDATA" *)
    input  wire [7:0]  s_axis_tdata,
    (* X_INTERFACE_INFO = "xilinx.com:interface:axis:1.0 s_axis TVALID" *)
    input  wire        s_axis_tvalid,
    (* X_INTERFACE_INFO = "xilinx.com:interface:axis:1.0 s_axis TREADY" *)
    output wire        s_axis_tready,
    (* X_INTERFACE_INFO = "xilinx.com:interface:axis:1.0 s_axis TLAST" *)
    input  wire        s_axis_tlast,

    (* X_INTERFACE_INFO = "xilinx.com:interface:axis:1.0 m_axis TDATA" *)
    output wire [7:0]  m_axis_tdata,
    (* X_INTERFACE_INFO = "xilinx.com:interface:axis:1.0 m_axis TVALID" *)
    output wire        m_axis_tvalid,
    (* X_INTERFACE_INFO = "xilinx.com:interface:axis:1.0 m_axis TREADY" *)
    input  wire        m_axis_tready,
    (* X_INTERFACE_INFO = "xilinx.com:interface:axis:1.0 m_axis TLAST" *)
    output wire        m_axis_tlast
);

    engine_glue u_glue (
        .clk(aclk), .rst_n(aresetn),
        .awaddr(s_axil_awaddr), .awvalid(s_axil_awvalid), .awready(s_axil_awready),
        .wdata(s_axil_wdata), .wstrb(s_axil_wstrb), .wvalid(s_axil_wvalid), .wready(s_axil_wready),
        .bresp(s_axil_bresp), .bvalid(s_axil_bvalid), .bready(s_axil_bready),
        .araddr(s_axil_araddr), .arvalid(s_axil_arvalid), .arready(s_axil_arready),
        .rdata(s_axil_rdata), .rresp(s_axil_rresp), .rvalid(s_axil_rvalid), .rready(s_axil_rready),
        .s_tdata(s_axis_tdata), .s_tvalid(s_axis_tvalid), .s_tready(s_axis_tready),
        .m_tdata(m_axis_tdata), .m_tvalid(m_axis_tvalid), .m_tready(m_axis_tready),
        .m_tlast(m_axis_tlast)
    );

    // The input stream's TLAST is not needed: each pass knows its size
    wire _unused = &{s_axis_tlast, 1'b0};

endmodule

`default_nettype wire
