izaiah-thigpen/tt-sparse-conv/(commit log)

2026-10-22 Add sparsity-aware convolution core
    8-bit 3x3 multiply-accumulate core with zero-skip gating behind an SPI
    command interface. Tests drive the pins only and check every result
    against the bit-exact reference model.
    Claude-Session: https://claude.ai/code/session_01WuUZbH4cddB8o6Ya7TKaqN
2026-10-22 Add a host test kit for the fabricated chip
    host/ lets someone test the chip on a Tiny Tapeout demo board without the
    designer: chip_protocol.py converts data to SPI commands and replies back
    to numbers; board/bringup.py runs smoke tests and stored network vectors on
    the RP2040 and prints PASS/FAIL per check; make_vectors.py and
    spi_convert.py run on a PC.
    test/test_host.py runs the unchanged board program against the design in
    cocotb, so CI checks the kit on the RTL and the gate-level netlist. The
    vectors are a random model for now.
    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
2026-10-22 Add an activity mode for measuring the gating's energy saving
    SET_ACTIVITY (0x30) sets a zero threshold; RUN (0x31) issues N generated
    taps, one per clock, with no SPI traffic (N = 0 runs until STOP, 0x32).
    Pixels come from an xorshift32 generator reseeded at each RUN; weights
    cycle through the nine loaded weights. With SPI the multiplier works one
    clock in 64 or fewer, so this makes the gated-versus-bypass current
    difference large enough to measure on silicon.
    Tests check accumulator and skip count against refmodel.activity_run at
    five thresholds, gated, ungated and with BYPASS, plus wraparound,
    saturation and RUN-until-STOP. Six planted bugs were all caught.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
2026-10-22 Add the power sweep, its simulated prediction, and activity-mode docs
    - host/board/bringup.py: activity-mode checks in the quick test, and
    power_sweep(), a guided supply-current measurement across zero shares,
    gated and with BYPASS.
    - host/tests/chip_emulator.py: models the activity mode.
    - power/: gate-level power estimate of the same sweep (Yosys to sky130 cells,
    Icarus + cocotb activity, OpenSTA report_power). The MAC's dynamic power falls
    23% at 50% zero taps and 66% at 90%.
    - docs/info.md and host/README.md: the SET_ACTIVITY, RUN and STOP commands and
    how to measure the saving.
    Claude-Session: https://claude.ai/code/sess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
2026-10-22 Use the trained model's test vectors
    host/vectors now holds the trained WaferNet (16 + 16 kernels, macro F1 0.82)
    and one WM-811K test map per class, replacing the random placeholder model.
    The board program passes 56 of 56 checks in full mode against the chip
    emulator and passes against the chip RTL. No chip files change.
    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
2026-10-23 Add the FPGA version and its recorded hardware run
    fpga/rtl: the nine-MAC convolution engine with AXI-Lite registers and AXI-Stream
    I/O. fpga/pynq: the Vivado build script (DMA-to-DDR path wired explicitly),
    the PYNQ driver, and demo.ipynb saved with its outputs from the PYNQ-Z1: all
    180 demo maps bit-exact against the reference model, 75.6% accuracy, 68.1% of
    multiply-accumulates skipped, 100 MHz met with 1.81 ns of slack.
    No chip files change.
    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
2026-10-23 Add the host board schematic (rev A)
    pcb/: a KiCad project for a host board that replaces the Tiny Tapeout demo
    board for power measurement. It keeps the demo board v3's RP2350B pin map, so
    the TT firmware and host/ test kit run unchanged, and adds an INA228 power
    monitor on the chip's 1.8 V core supply (0.499 + 4.99 ohm shunt, 14 nA steps).
    The schematic is generated from pcb/gen/design.py. KiCad's exported netlist
    matches the design net for net, the breakout socket pin map matches the demo
    board, and every symbol pin has a footprint pad. Derived from Tiny Tapeout's
    demo board and breakout designs (Apache 2.0). No chip files change.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
2026-10-23 Host board: unique power-symbol references across sheets
    Power symbols were named after the first three letters of their sheet file, so
    power.kicad_sch and power_monitor.kicad_sch collided (#PWRPOW001-012) and
    KiCad 9's annotator reported duplicates. Nets unchanged; netlist check passes.
    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
2026-10-23 Host board: bundle the two footprints KiCad 9 lacks
    KiCad 9's ERC found no errors, but L_2016X120N (RP2350 core-regulator
    inductor, from the demo board's private library) and VSSOP-10_3x3mm_P0.5mm
    (INA228) were not in its standard libraries. Both now live in the project's
    SparseConvHost.pretty. Netlist and footprint checks pass.
    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
2026-10-23 Read the host board's INA228 automatically in the power sweep
    host/board/ina228.py: MicroPython driver for the INA228 on the host board
    (SoftI2C on GPIO12/13, address 0x40): shunt voltage, core voltage, energy.
    power_sweep() now detects it, holds each step 5 s, records mean current,
    spread, core voltage and energy-based power, and prints gated vs ungated
    power per zero share. It runs the chip at 50 MHz. On a demo board it falls
    back to the guided external-meter procedure.
    Tested with a register-level INA228 model tied to the chip emulator, on
    CPython and MicroPython; the quick test still passes 19 of 19.
    Claude-Session: https://claude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
2026-10-24 Host board: starting placement from the demo board's arrangement
    All 110 footprints placed on a 100 x 85 mm, 4-layer board with the design
    rules set. Parts shared with the Tiny Tapeout demo board keep its proven
    positions (shifted so its breakout socket lands on our J3); the power
    monitor, analog pull-downs, SWD and logic-analyzer headers and mounting
    holes are new. The placement script checks courtyard overlaps, board fit
    and the under-breakout height limit.
    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
